feyzijan/BioFuelEngineECU/Arduino_Codes/Putty_Outputs/OutputData/test13-14.jpeg

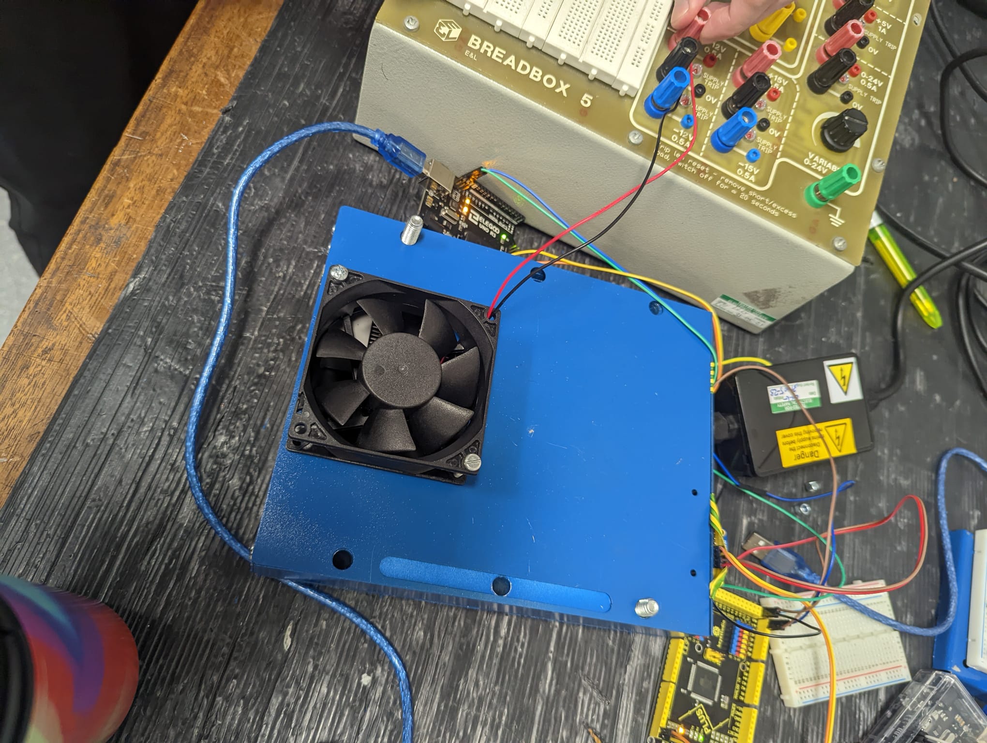
Arduino_Codes/Putty_Outputs/OutputData/test13-14.jpeg
