feyzijan/BioFuelEngineECU/Arduino_Codes/Putty_Outputs/OutputData/test11-12-setup.jpeg

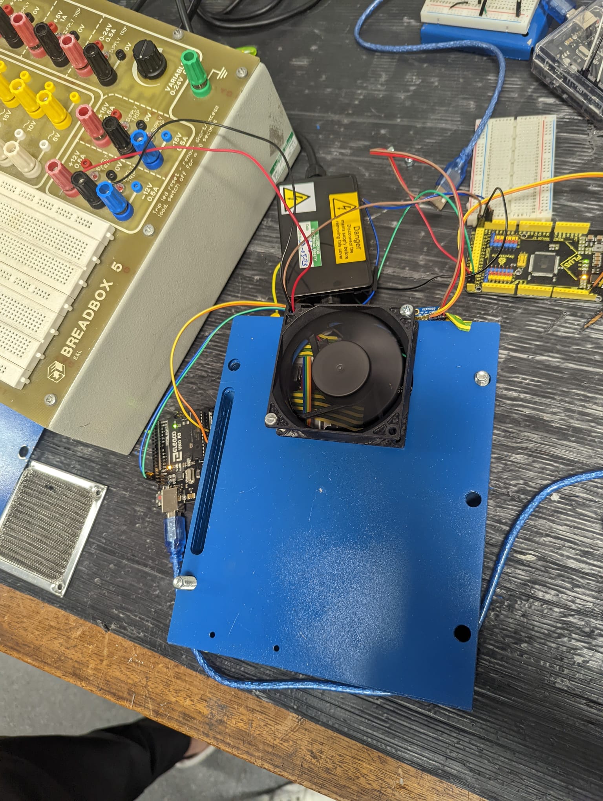
Arduino_Codes/Putty_Outputs/OutputData/test11-12-setup.jpeg
