feyzijan/BioFuelEngineECU/SIMULINK/PreliminaryFlowCharts.pdf

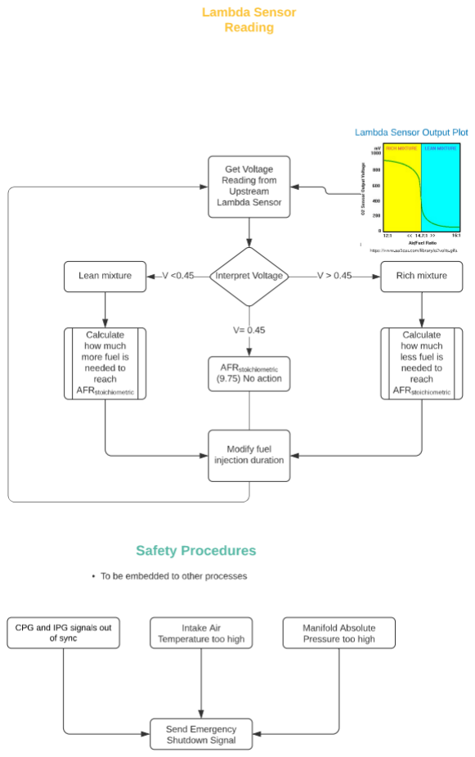
[picture p3: figure]
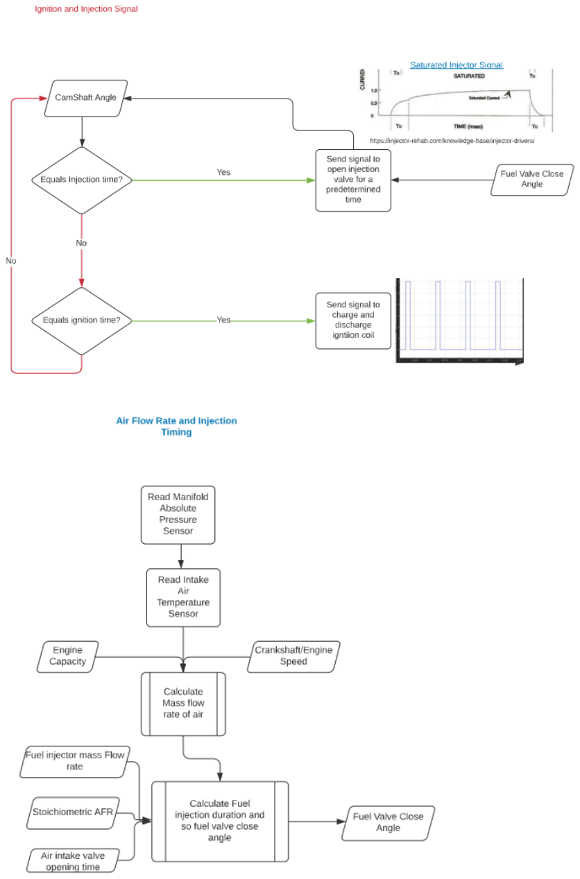
[picture p4: page 2]

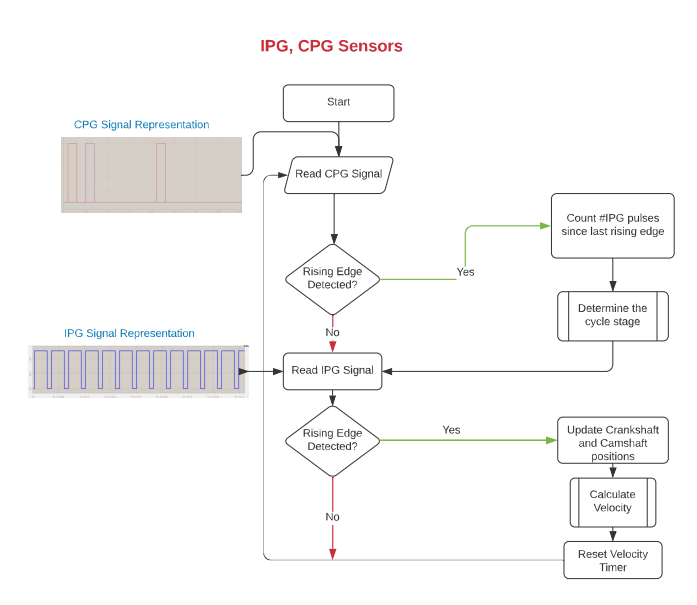
[picture p5: figure]
