feyzijan/BioFuelEngineECU/SIMULINK/GraphsAndPics/FuelHeater.pdf

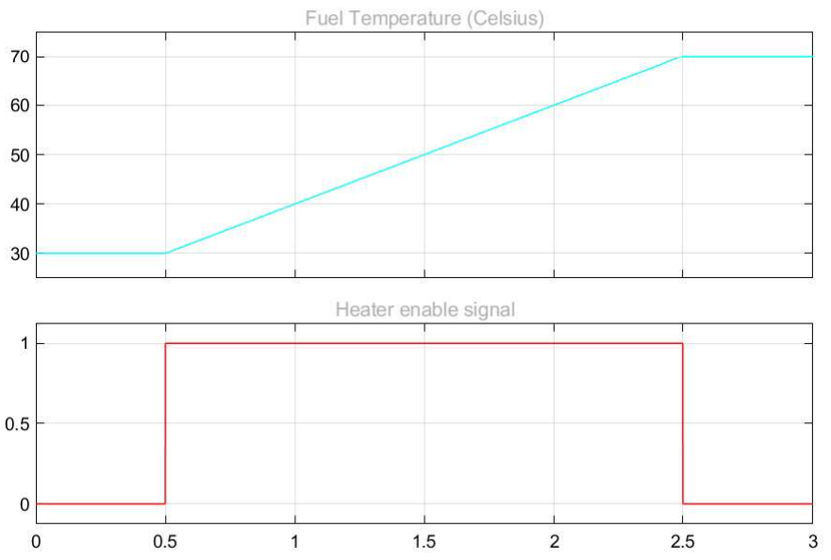
[picture p6: figure]
