feyzijan/BioFuelEngineECU/SIMULINK/GraphsAndPics/SteadyState Plot.pdf

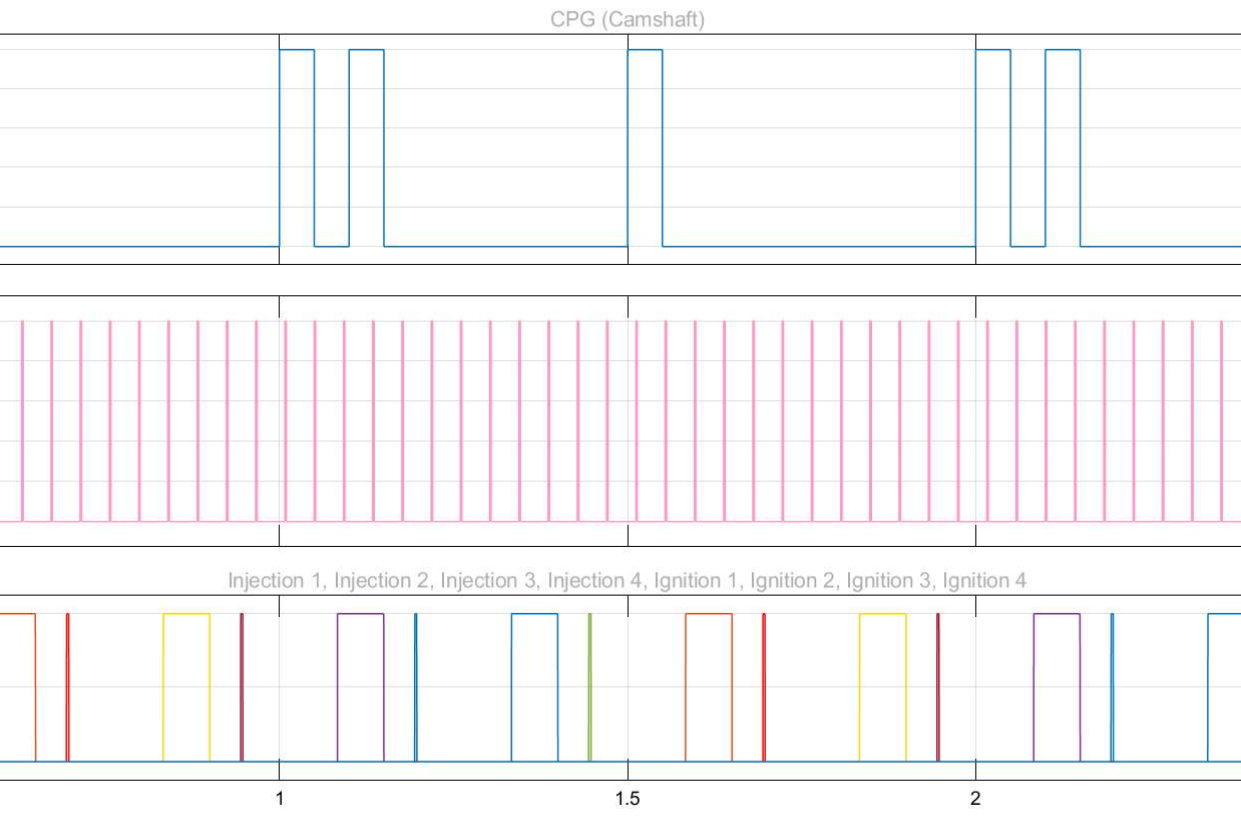
[picture p7: figure]
