feyzijan/BioFuelEngineECU/SIMULINK/GraphsAndPics/TransientPlot.pdf

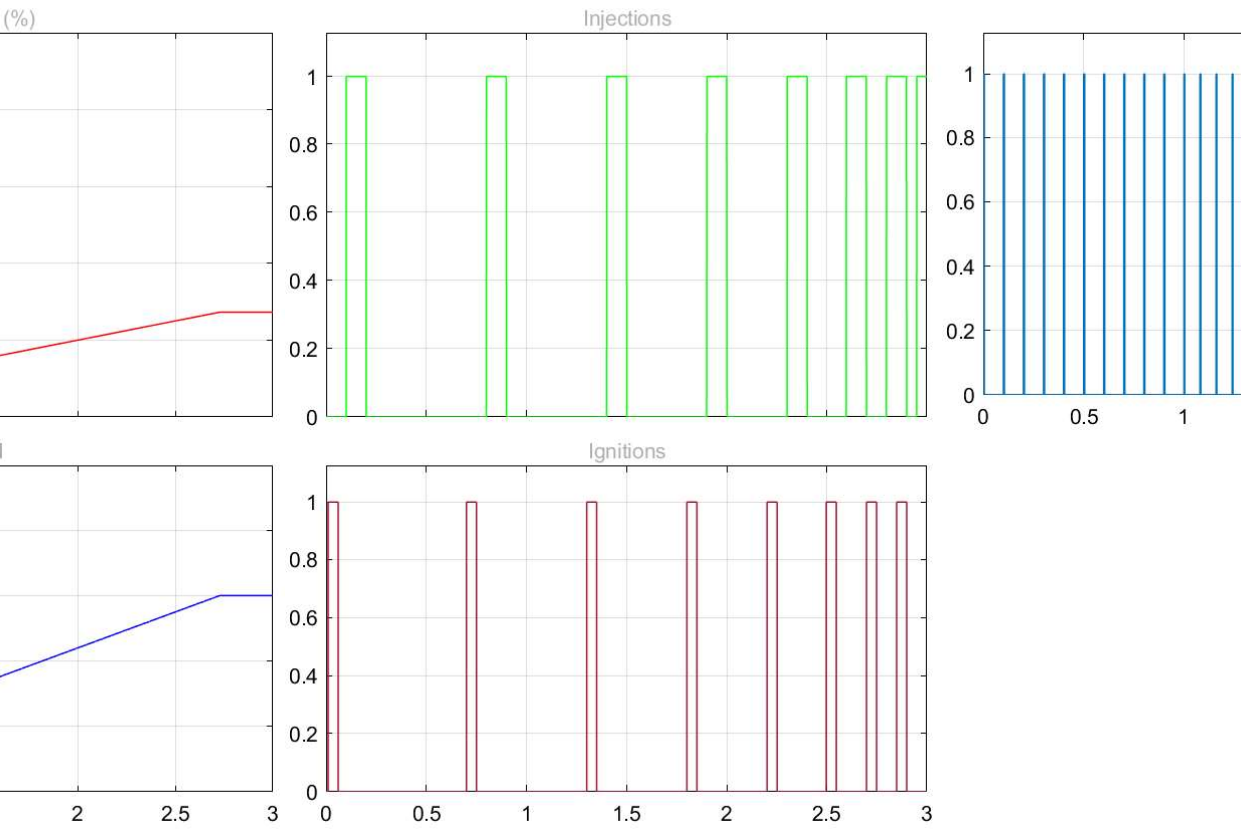
[picture p8: figure]
