feyzijan/BioFuelEngineECU/Engine_Models_Calcs/Example MAP Variation With Engine Speed.png

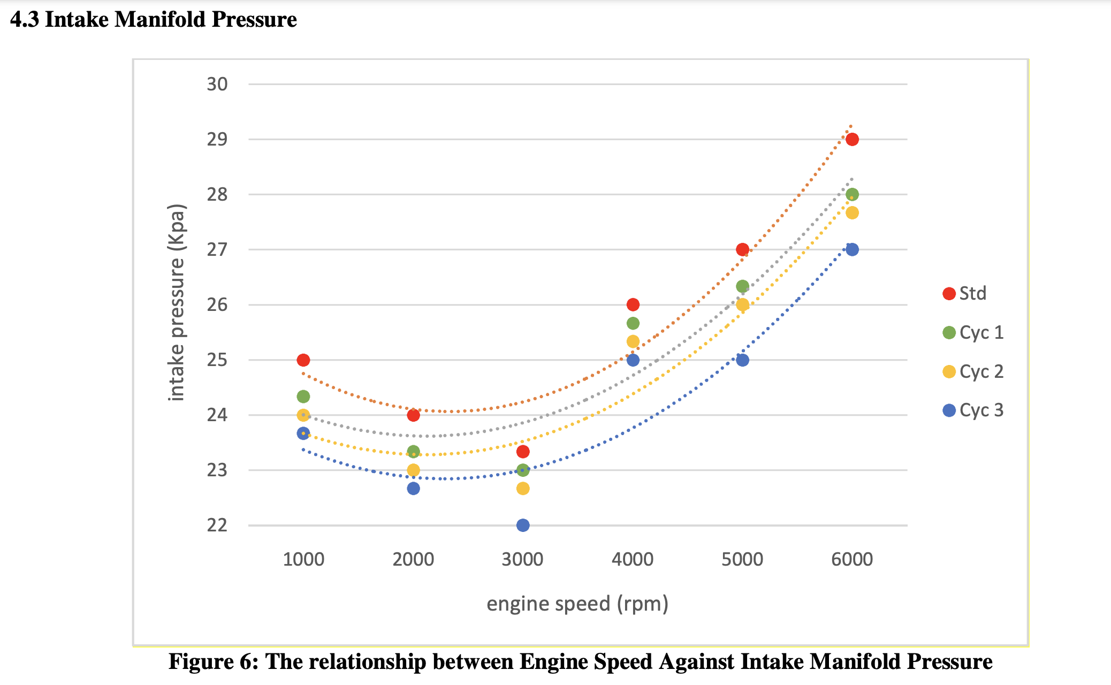
Engine_Models_Calcs/Example MAP Variation With Engine Speed.png
