feyzijan/BioFuelEngineECU/Engine_Models_Calcs/Example Volumetric Efficiency With Speed.png

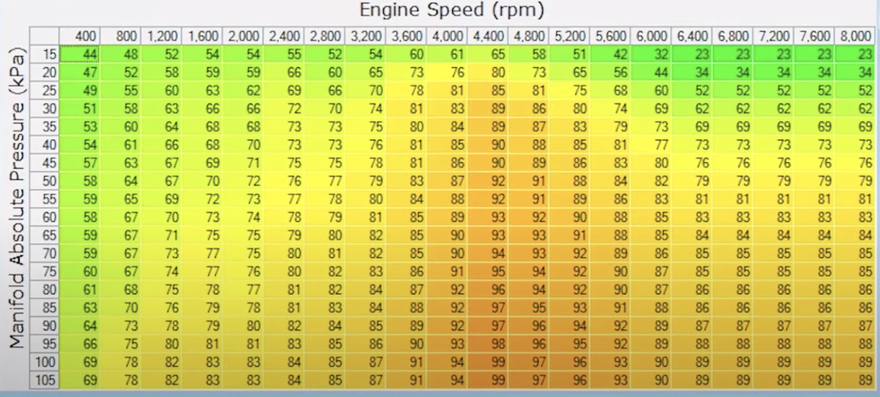
Engine_Models_Calcs/Example Volumetric Efficiency With Speed.png
