feyzijan/BioFuelEngineECU/PCB/V2/PCB3D.jpg

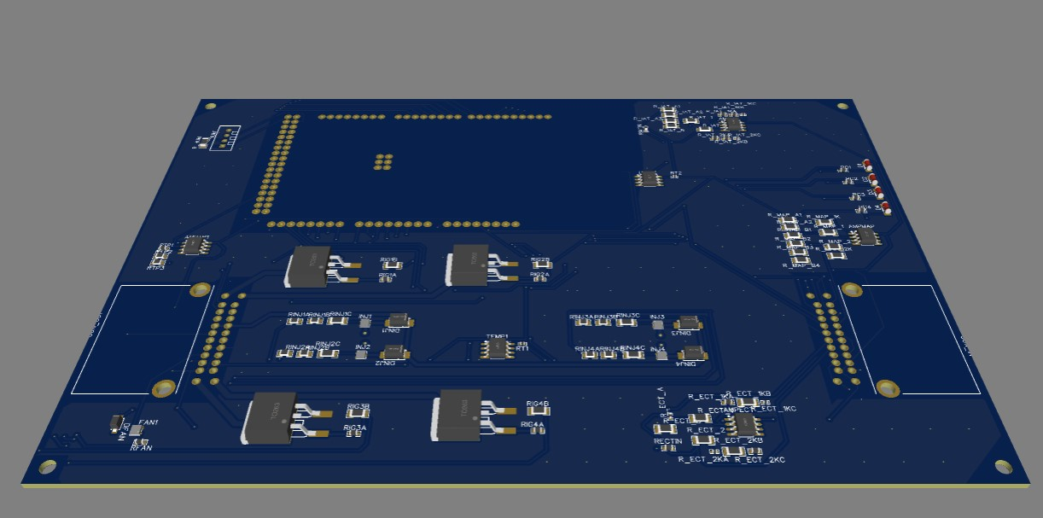
PCB/V2/PCB3D.jpg
