feyzijan/BioFuelEngineECU/PCB/V2/PCBBottom2D.jpg

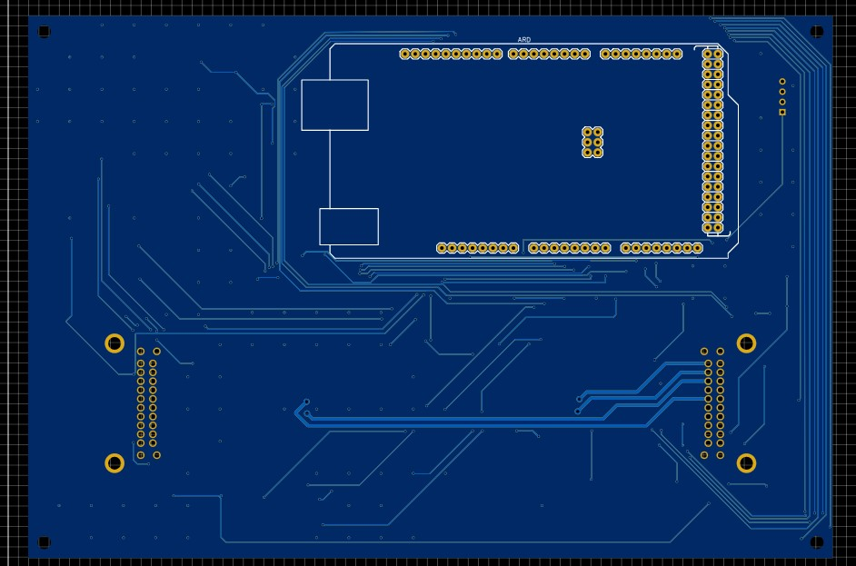
PCB/V2/PCBBottom2D.jpg
