feyzijan/BioFuelEngineECU/PCB/V2/PCBTop2D.jpg

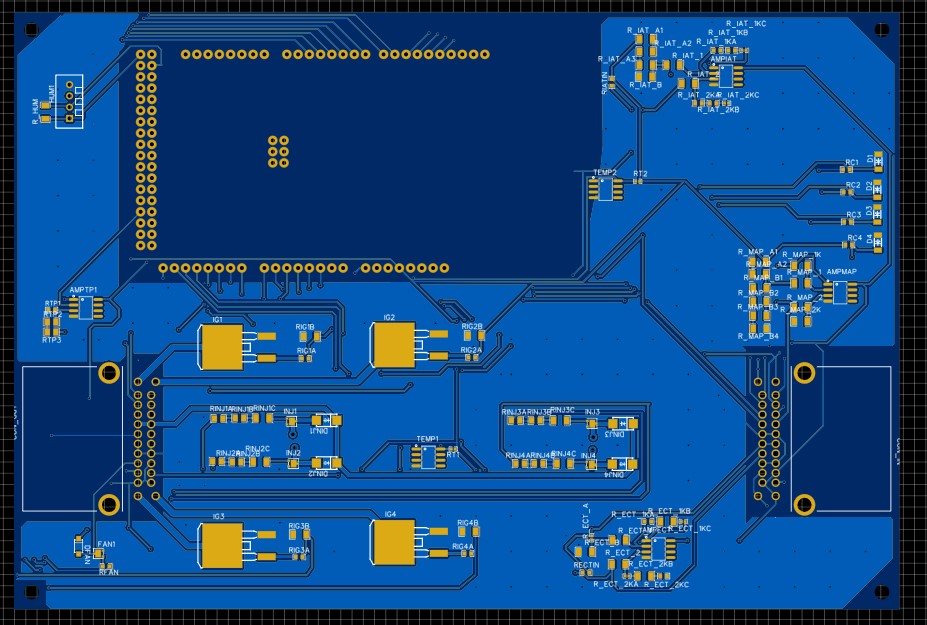
PCB/V2/PCBTop2D.jpg
