feyzijan/BioFuelEngineECU/SIMULINK/GraphsAndPics/3000RPMTimings.png

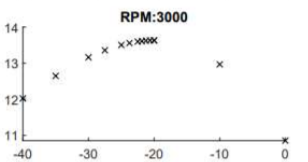
SIMULINK/GraphsAndPics/3000RPMTimings.png
