feyzijan/BioFuelEngineECU/SIMULINK/GraphsAndPics/Fuel Injection Duration Calculator-Detail.png

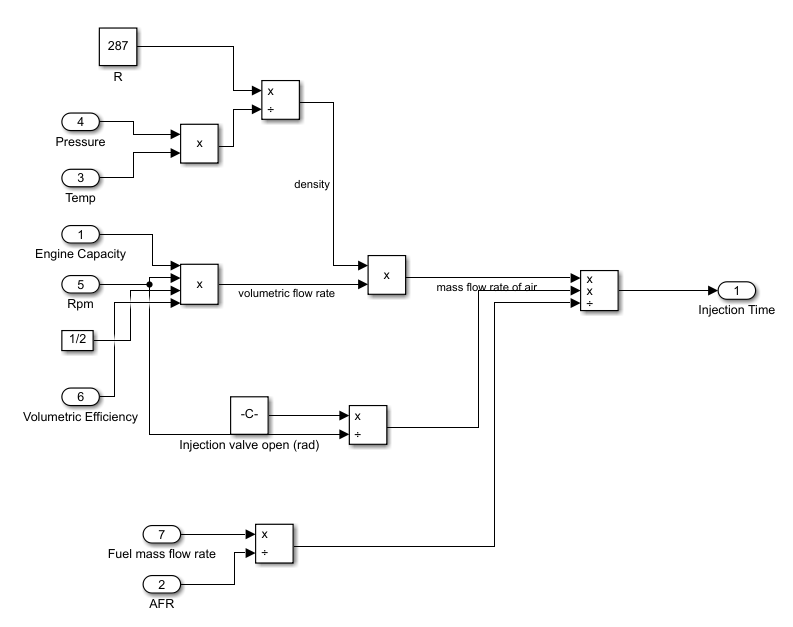
SIMULINK/GraphsAndPics/Fuel Injection Duration Calculator-Detail.png
