feyzijan/BioFuelEngineECU/SIMULINK/GraphsAndPics/Fuel Injection Duration Calculatır.png

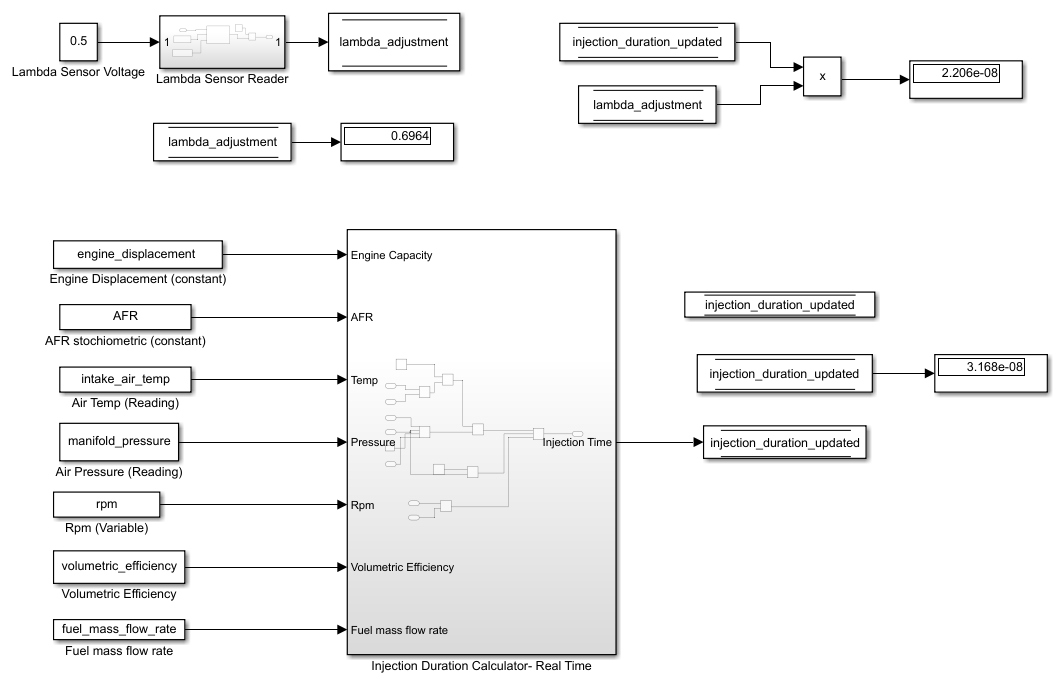
SIMULINK/GraphsAndPics/Fuel Injection Duration Calculatır.png
