feyzijan/BioFuelEngineECU/SIMULINK/GraphsAndPics/SteadyStatePlot.png

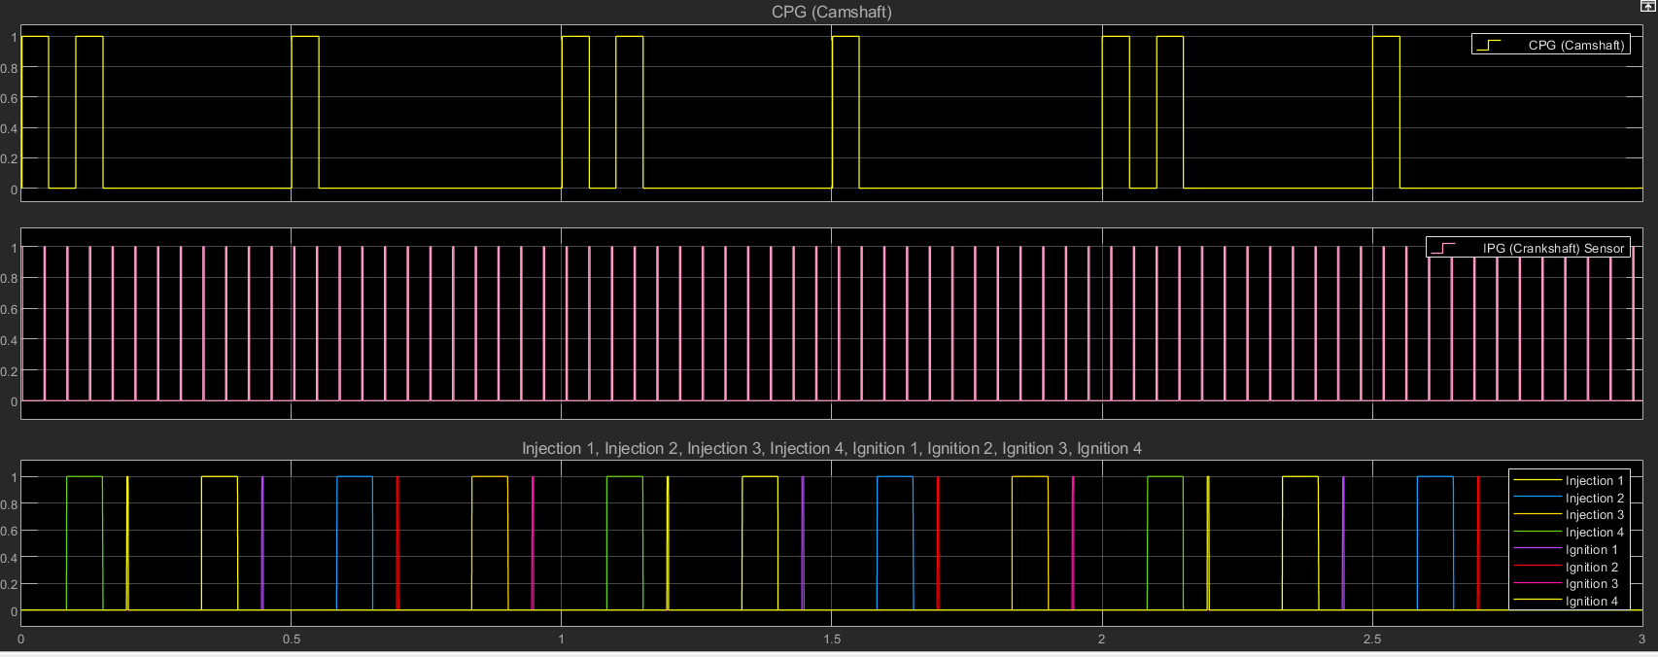
SIMULINK/GraphsAndPics/SteadyStatePlot.png
