feyzijan/BioFuelEngineECU/SIMULINK/GraphsAndPics/Transient State.png

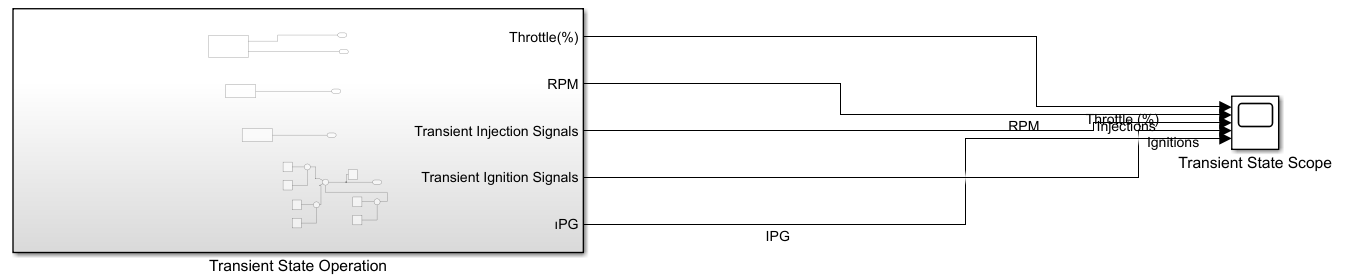
SIMULINK/GraphsAndPics/Transient State.png
