feyzijan/BioFuelEngineECU/SIMULINK/GraphsAndPics/TransientPlot.png

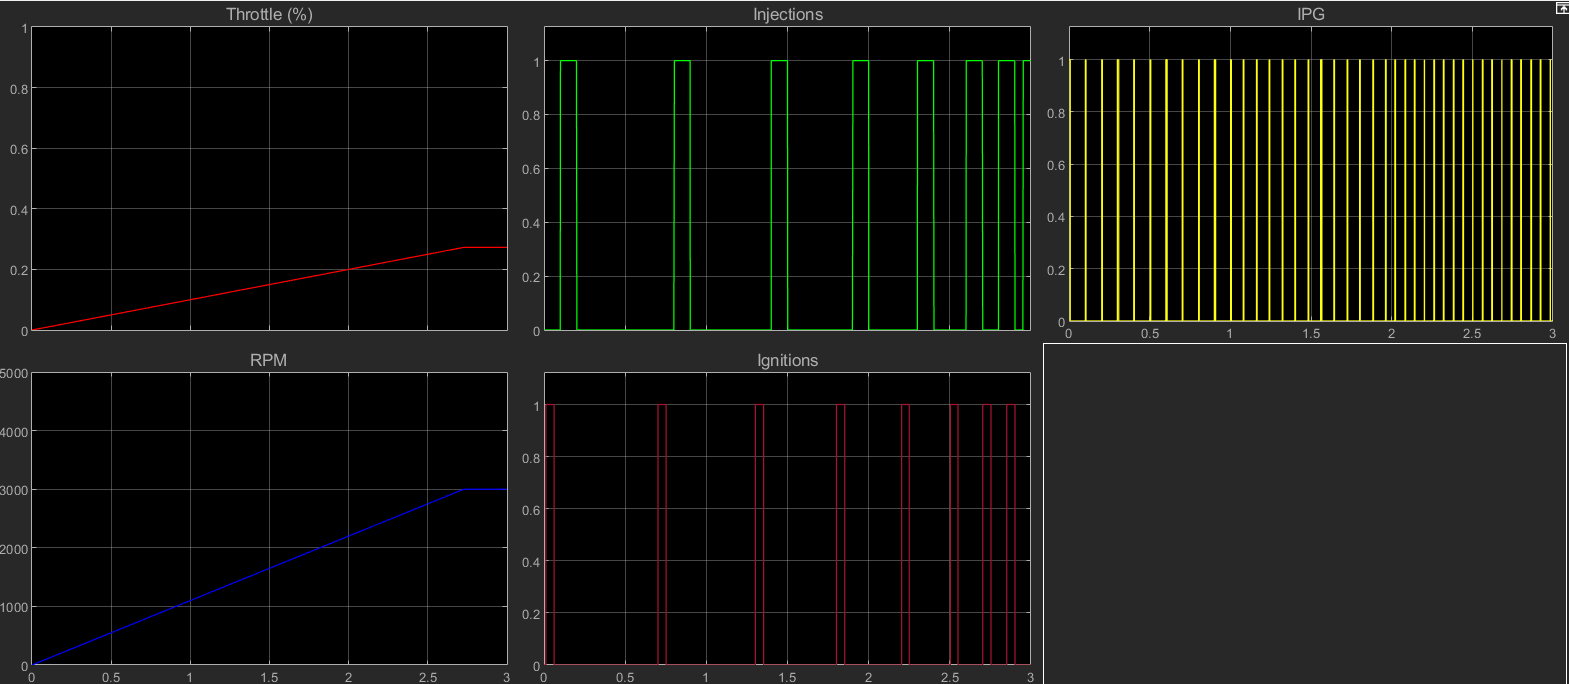
SIMULINK/GraphsAndPics/TransientPlot.png
