feyzijan/BioFuelEngineECU/PCB/V2/ProductionFiles/BOM_PCB_SecondPCBOrder_2022-04-07.csv

ID | Name | Designator | Footprint | Quantity | Manufacturer Part | Manufacturer | Supplier | Supplier Part | Price | Total Price
1 | ZMM4.7 | D4,D1,D2,D3 | LL-34_L3.5-W1.5-RD | 4 | ZMM4.7 | (DIOTEC) | LCSC | C212756 | 0.032 | 0.128
2 | 20K? | RC4 | R0603 | 1 | 0603WAF1001T5E | UniOhm | LCSC | C21190 | 0.001 | 0.001
3 | 1K | RECTIN,RIATIN,RTP1,RFAN,RC1,RC2,RC3,RIG1A,RIG2A,RIG3A,RIG4A | R0603 | 11 | 0603WAF1001T5E | UniOhm | LCSC | C21190 | 0.001 | 0.011
4 | AS358AMTR-E1 | AMPTP1,AMPECT,AMPIAT,AMPMAP | SOIC-8_L4.9-W3.9-P1.27-LS6.0-BL | 4 | AS358AMTR-E1 | Diodes Incorporated | LCSC | C141322 | 0.125 | 0.5
5 | 1.2K | RTP2 | R0805 | 1 | 0805W8F1201T5E | UniOhm | LCSC | C17379 | 0.002 | 0.002
6 | 200 | RTP3,RINJ1A,RINJ2A,RINJ3A,RINJ4A | R0805 | 5 | 0805W8F2000T5E | UniOhm | LCSC | C17540 | 0.002 | 0.01
7 | 2kΩ | RT1,RT2,R_ECT_1KC,R_ECT_2KA | R0402 | 4 | 0402WGF2001TCE | UniOhm | LCSC | C4109 | 0.001 | 0.004
8 | LM335DT | TEMP1,TEMP2 | SOIC-8_L4.9-W3.9-P1.27-LS6.0-BL | 2 | LM335DT | STMicroelectronics | LCSC | C7946 | 1.23 | 2.46
9 | PBSS4330PA,115 | FAN1,INJ1,INJ2,INJ3,INJ4 | DFN2020-3_L2.0-W2.0-P0.65-BR | 5 | PBSS4330PA,115 | Nexperia | LCSC | C458167 | 0.226 | 1.13
10 | 1N4148W_C81598 | DFAN | SOD-123F_L2.7-W1.6-LS3.8-RD | 1 | 1N4148W | SEMTECH | LCSC | C81598 | 0.013 | 0.013
11 | M7_C95872 | DINJ1,DINJ2,DINJ3,DINJ4 | DO-214AC_L4.3-W2.7-LS5.3-RD | 4 | M7 | MDD | LCSC | C95872 | 0.009 | 0.036
12 | ISL9V3040S3ST | IG1,IG2,IG3,IG4 | TO-263AB_L10.0-W8.5-P2.54-LS15.9-TL | 4 | ISL9V3040S3ST | ON(安森美) | LCSC | C898702 | 2.37 | 9.48
13 | 10K | RIG1B,RIG2B,RIG3B,RIG4B,R_HUM | R1206 | 5 | 1206W4F1002T5E | UniOhm | LCSC | C17902 | 0.004 | 0.02
14 | 10 | RINJ1C,RINJ2C,RINJ3C,RINJ4C | R1206 | 4 | 1206W4F100JT5E | UniOhm | LCSC | C17903 | 0.005 | 0.02
15 | 300 | RINJ1B,RINJ2B,RINJ3B,RINJ4B | R0805 | 4 | 0805W8F3000T5E | UniOhm | LCSC | C17617 | 0.002 | 0.008
16 | 100kΩ | R_ECT_1,R_ECT_2,R_IAT_1,R_IAT_2,R_MAP_1K,R_MAP_2K | R1206 | 6 | 1206W4F1003T5E | UniOhm | LCSC | C17900 | 0.004 | 0.024
17 | 120kΩ | R_ECT_1KA,R_ECT_2KC | R0603 | 2 | 0603WAF1203T5E | UniOhm | LCSC | C25808 | 0.001 | 0.002
18 | 10kΩ | R_ECT_1KB,R_ECT_2KB,R_MAP_1,R_MAP_2 | R1206 | 4 | 1206W4F1002T5E | UniOhm | LCSC | C17902 | 0.004 | 0.016
19 | 150Ω | R_ECT_A | R0402 | 1 | 0402WGF1500TCE | UniOhm | LCSC | C25082 | 0.001 | 0.001
20 | 20Ω | R_ECT_B,R_MAP_B3,R_IAT_A2 | R1206 | 3 | 1206W4F200JT5E | UniOhm | LCSC | C17955 | 0.004 | 0.012
21 | 240kΩ | R_IAT_1KA,R_IAT_2KA | R0603 | 2 | 0603WAF2403T5E | UniOhm | LCSC | C4197 | 0.001 | 0.002
22 | 180kΩ | R_IAT_1KB,R_IAT_2KB | R0603 | 2 | 0603WAF1803T5E | UniOhm | LCSC | C22827 | 0.001 | 0.002
23 | 5.1kΩ | R_IAT_1KC,R_IAT_2KC | R0402 | 2 | 0402WGF5101TCE | UniOhm | LCSC | C25905 | 0.001 | 0.002
24 | 120Ω | R_IAT_A1,R_MAP_A1,R_MAP_A2,R_MAP_B1,R_MAP_B2 | R1206 | 5 | 1206W4F1200T5E | UniOhm | LCSC | C17909 | 0.004 | 0.02
25 | 1Ω | R_IAT_A3 | R1206 | 1 | 1206W4F100KT5E | UniOhm | LCSC | C17928 | 0.005 | 0.005
26 | 300Ω | R_IAT_B | R1206 | 1 | 1206W4F3000T5E | UniOhm | LCSC | C17887 | 0.004 | 0.004
27 | 10Ω | R_MAP_B4 | R1206 | 1 | 1206W4F100JT5E | UniOhm | LCSC | C17903 | 0.005 | 0.005
 |  |  |  |  |  |  |  |  | Sum | 13.918
