feyzijan/BioFuelEngineECU/PCB/DimensionsForHousing/PCBShape.SLDPRT

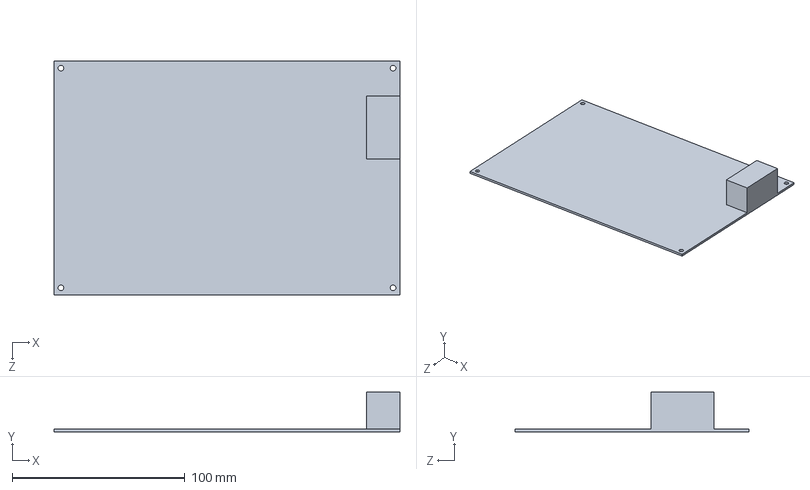
[picture p20: CAD file, 2022-09-23]
PCB/DimensionsForHousing/PCBShape.SLDPRT
200.0 x 22.8 x 135.0 mm
