feyzijan/BioFuelEngineECU/(list of files, cad)

Other CAD files:
PCB/DimensionsForHousing/PCBShape.SLDDRW
