feyzijan/BioFuelEngineECU/Arduino_Codes/Putty_Outputs/OutputData/test9-10setup.jpeg

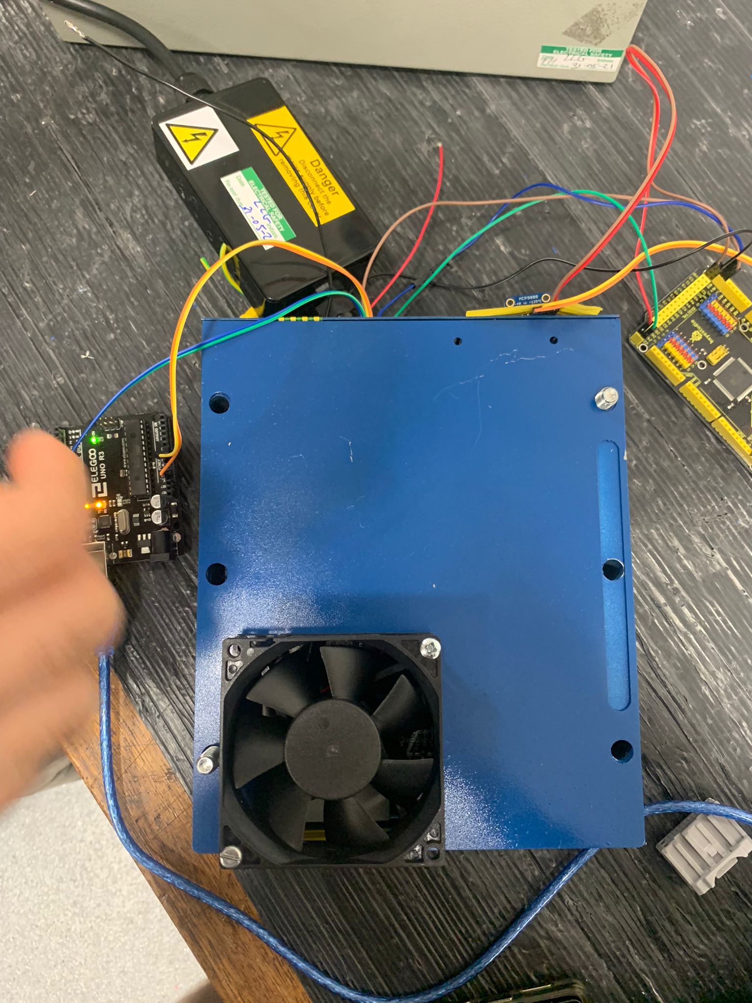
Arduino_Codes/Putty_Outputs/OutputData/test9-10setup.jpeg
