feyzijan/BioFuelEngineECU/SIMULINK/GraphsAndPics/Steady State Operation.png

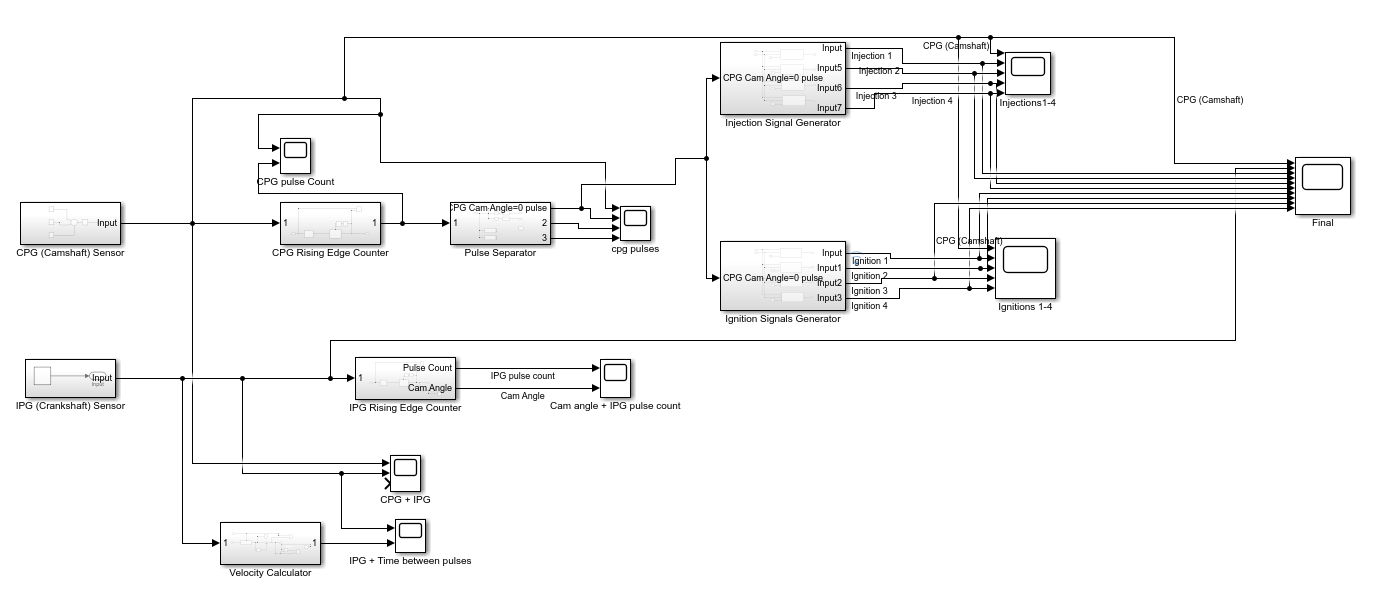
SIMULINK/GraphsAndPics/Steady State Operation.png
