feyzijan/BioFuelEngineECU/Arduino_Codes/ZenerDiodeCappingTestData.txt

2
2
2
2
2
61
61
83
86
78
78
90
90
69
69
133
133
237
237
353
353
525
525
668
664
667
663
599
598
670
666
715
708
771
759
815
795
844
818
919
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
