feyzijan/BioFuelEngineECU/Arduino_Codes/Putty_Outputs/OutputData/test15-16.jpeg

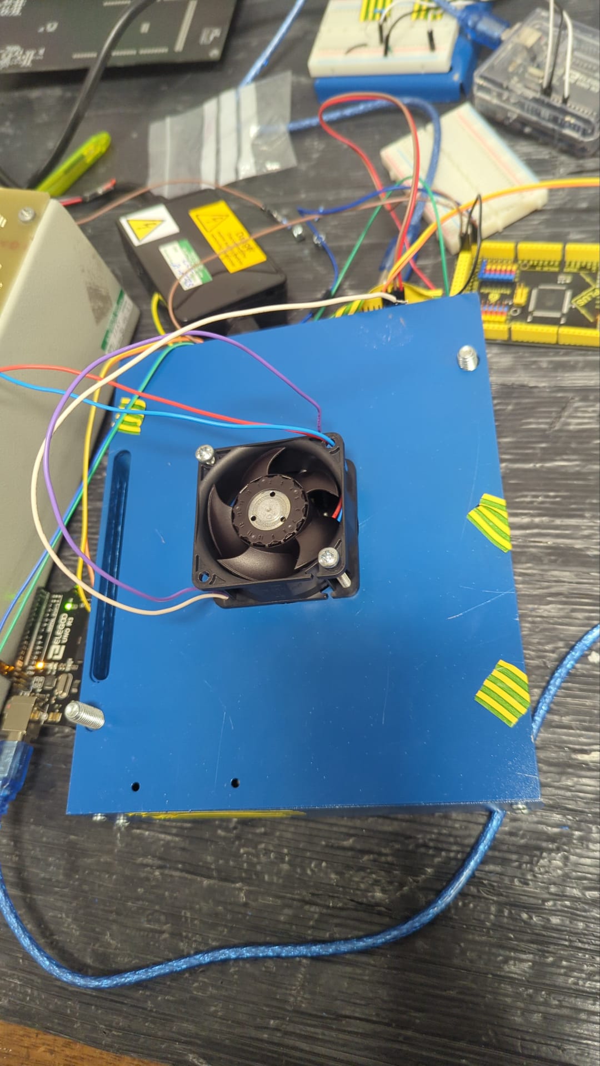
Arduino_Codes/Putty_Outputs/OutputData/test15-16.jpeg
