feyzijan/BioFuelEngineECU/Arduino_Codes/Putty_Outputs/Test2CalculationTime/Screenshot 2022-06-03 200349.jpg

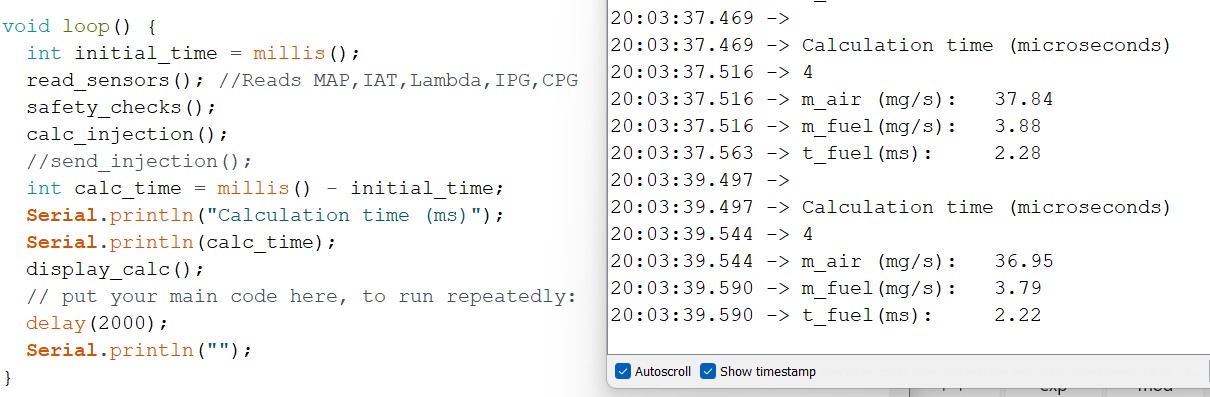
Arduino_Codes/Putty_Outputs/Test2CalculationTime/Screenshot 2022-06-03 200349.jpg
