feyzijan/BioFuelEngineECU/Arduino_Codes/Putty_Outputs/Test3C_CrankShaftPositionSensing/Screenshot 2022-06-04 124526.jpg

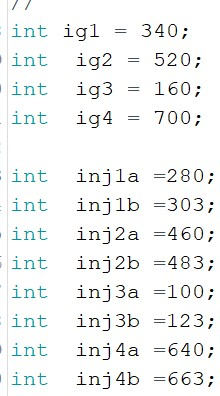
Arduino_Codes/Putty_Outputs/Test3C_CrankShaftPositionSensing/Screenshot 2022-06-04 124526.jpg
