feyzijan/BioFuelEngineECU/PCB/ElectronicsSchmeatic.pdf

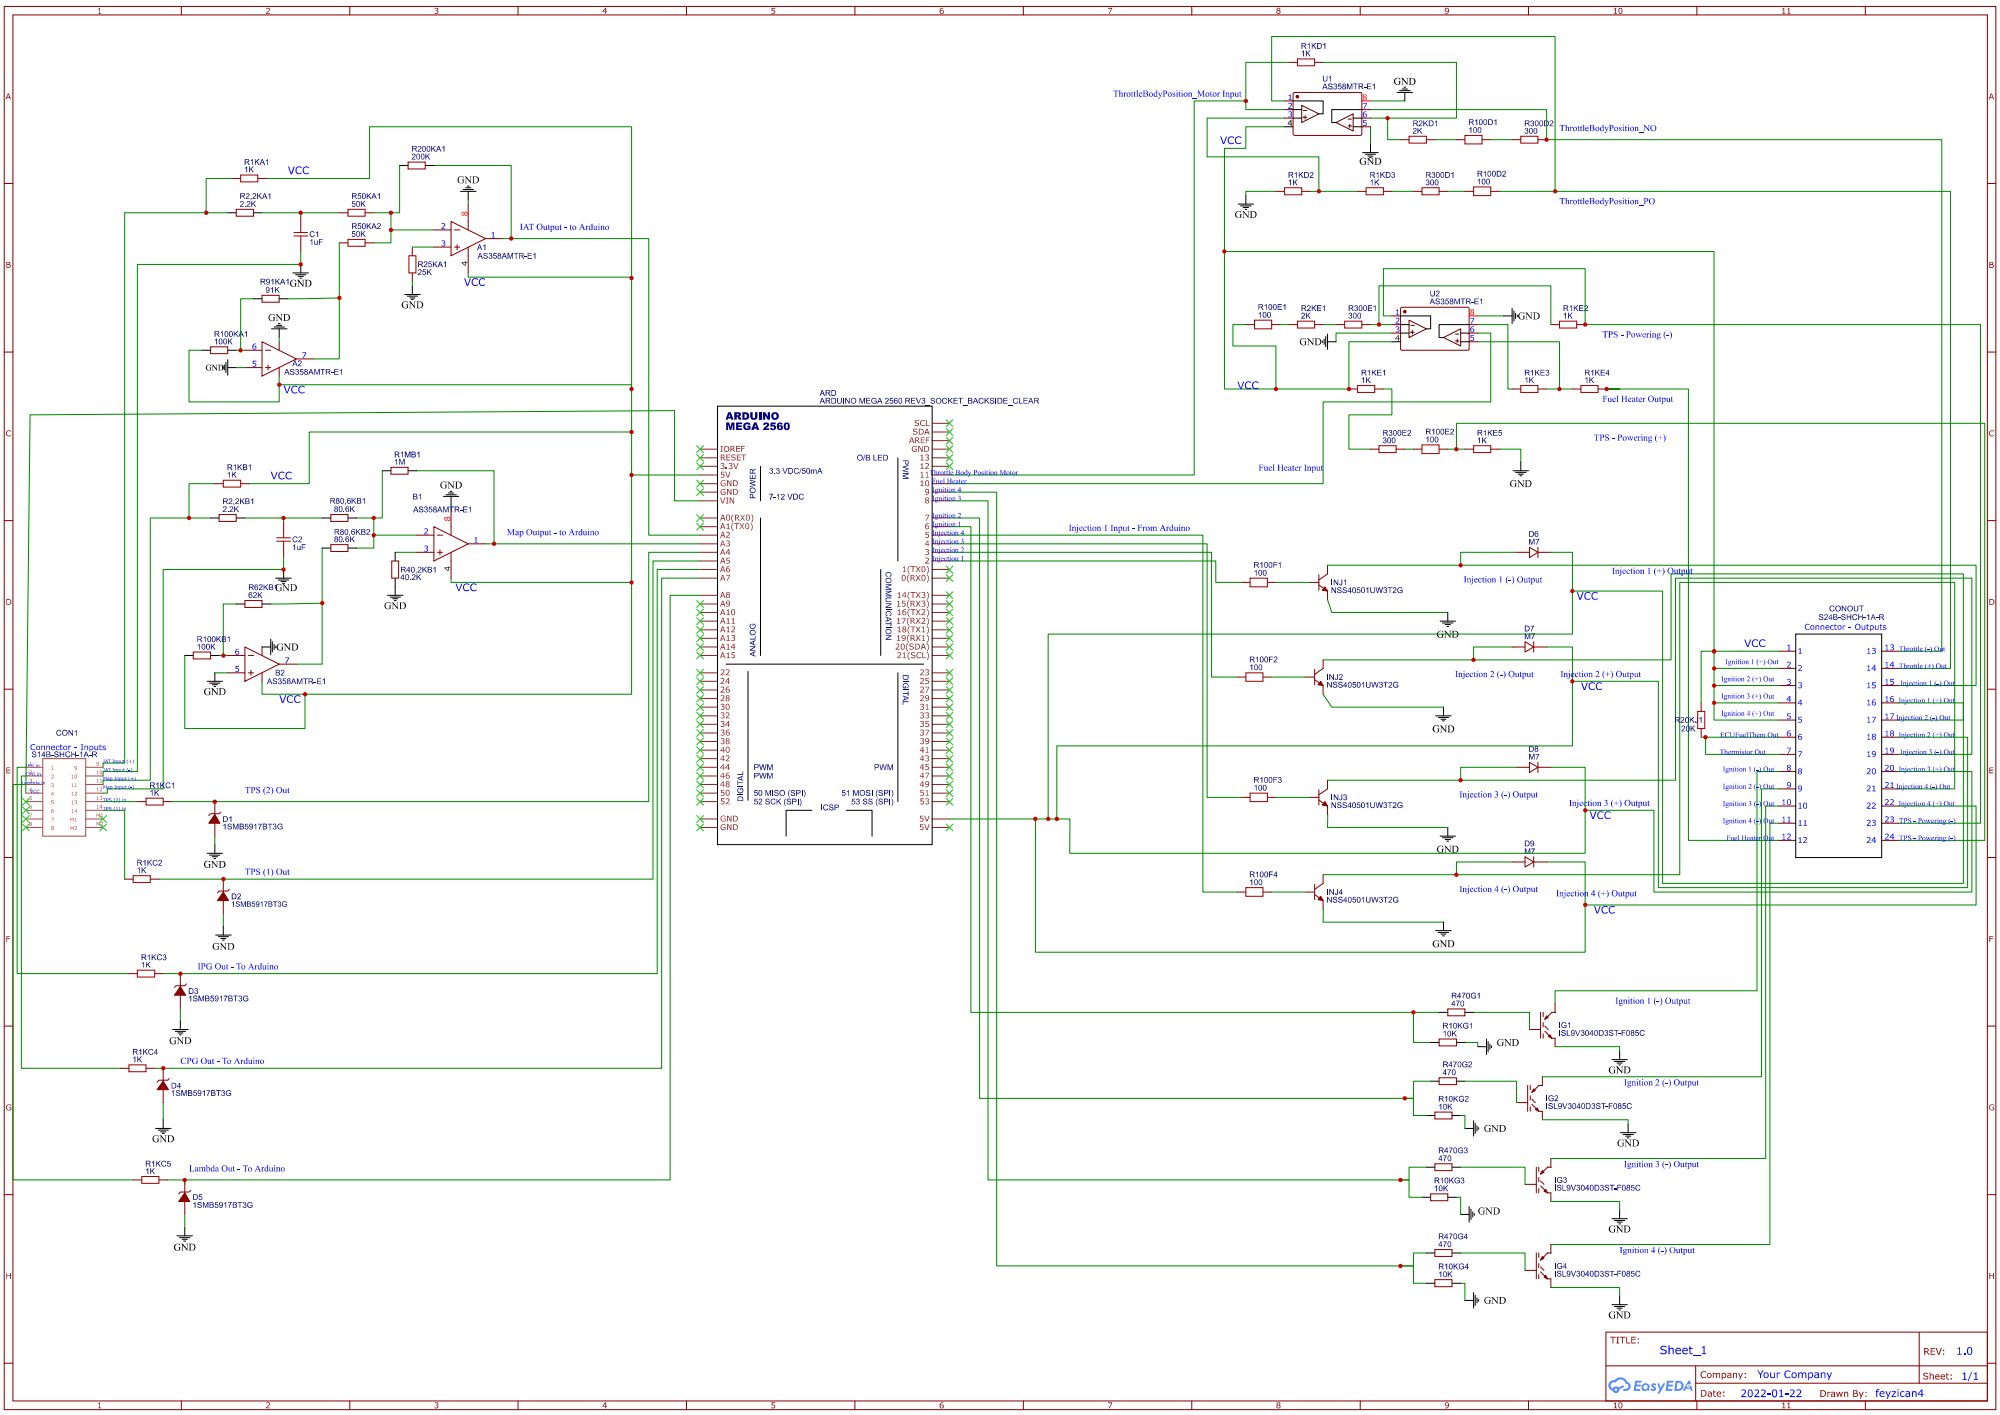
[picture p27: page 1]
