feyzijan/BioFuelEngineECU/(commit log)

2022-09-23 Added previously created files
    [BOMV4Notes.csv, BOM_PCBV2_2022-02-06.csv, BOM_PCBV3PriceCheck_2022-02-06.csv, BOM_PCBV4_2022-02-07.csv, BOM_PCB_PCB-Gateway_2022-01-25.csv, BOM_PCB_SecondPCBOrder_2022-04-07.csv, CamCalculator.xls, CustomBOM.xlsx]
2022-11-04 File reorganisation- renaming, deletion, etc.
    [BOMV4Notes.csv, BOM_PCBV2_2022-02-06.csv, BOM_PCBV3PriceCheck_2022-02-06.csv, BOM_PCBV4_2022-02-07.csv, BOM_PCB_PCB-Gateway_2022-01-25.csv, BOM_PCB_SecondPCBOrder_2022-04-07.csv, CamCalculator.xls, CustomBOM.xlsx]
